avakar/shupito/shupito23/front_design.pdf

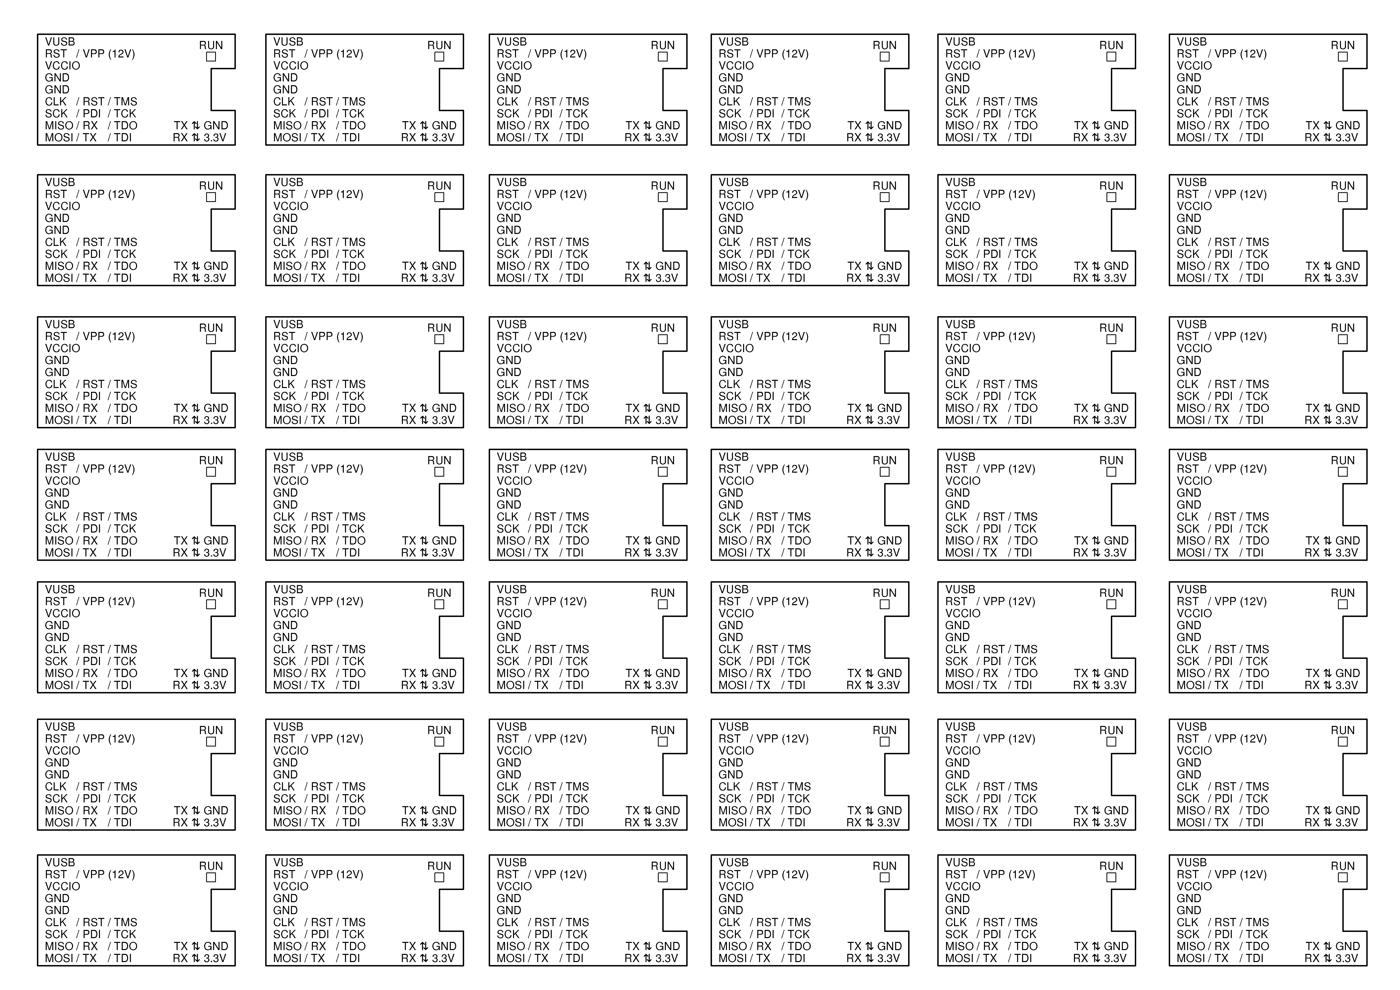
[picture p1: page 1]
