avakar/shupito/shupito23/shupito.brd

## EAGLE design shupito23/shupito.brd (2013-03-26)

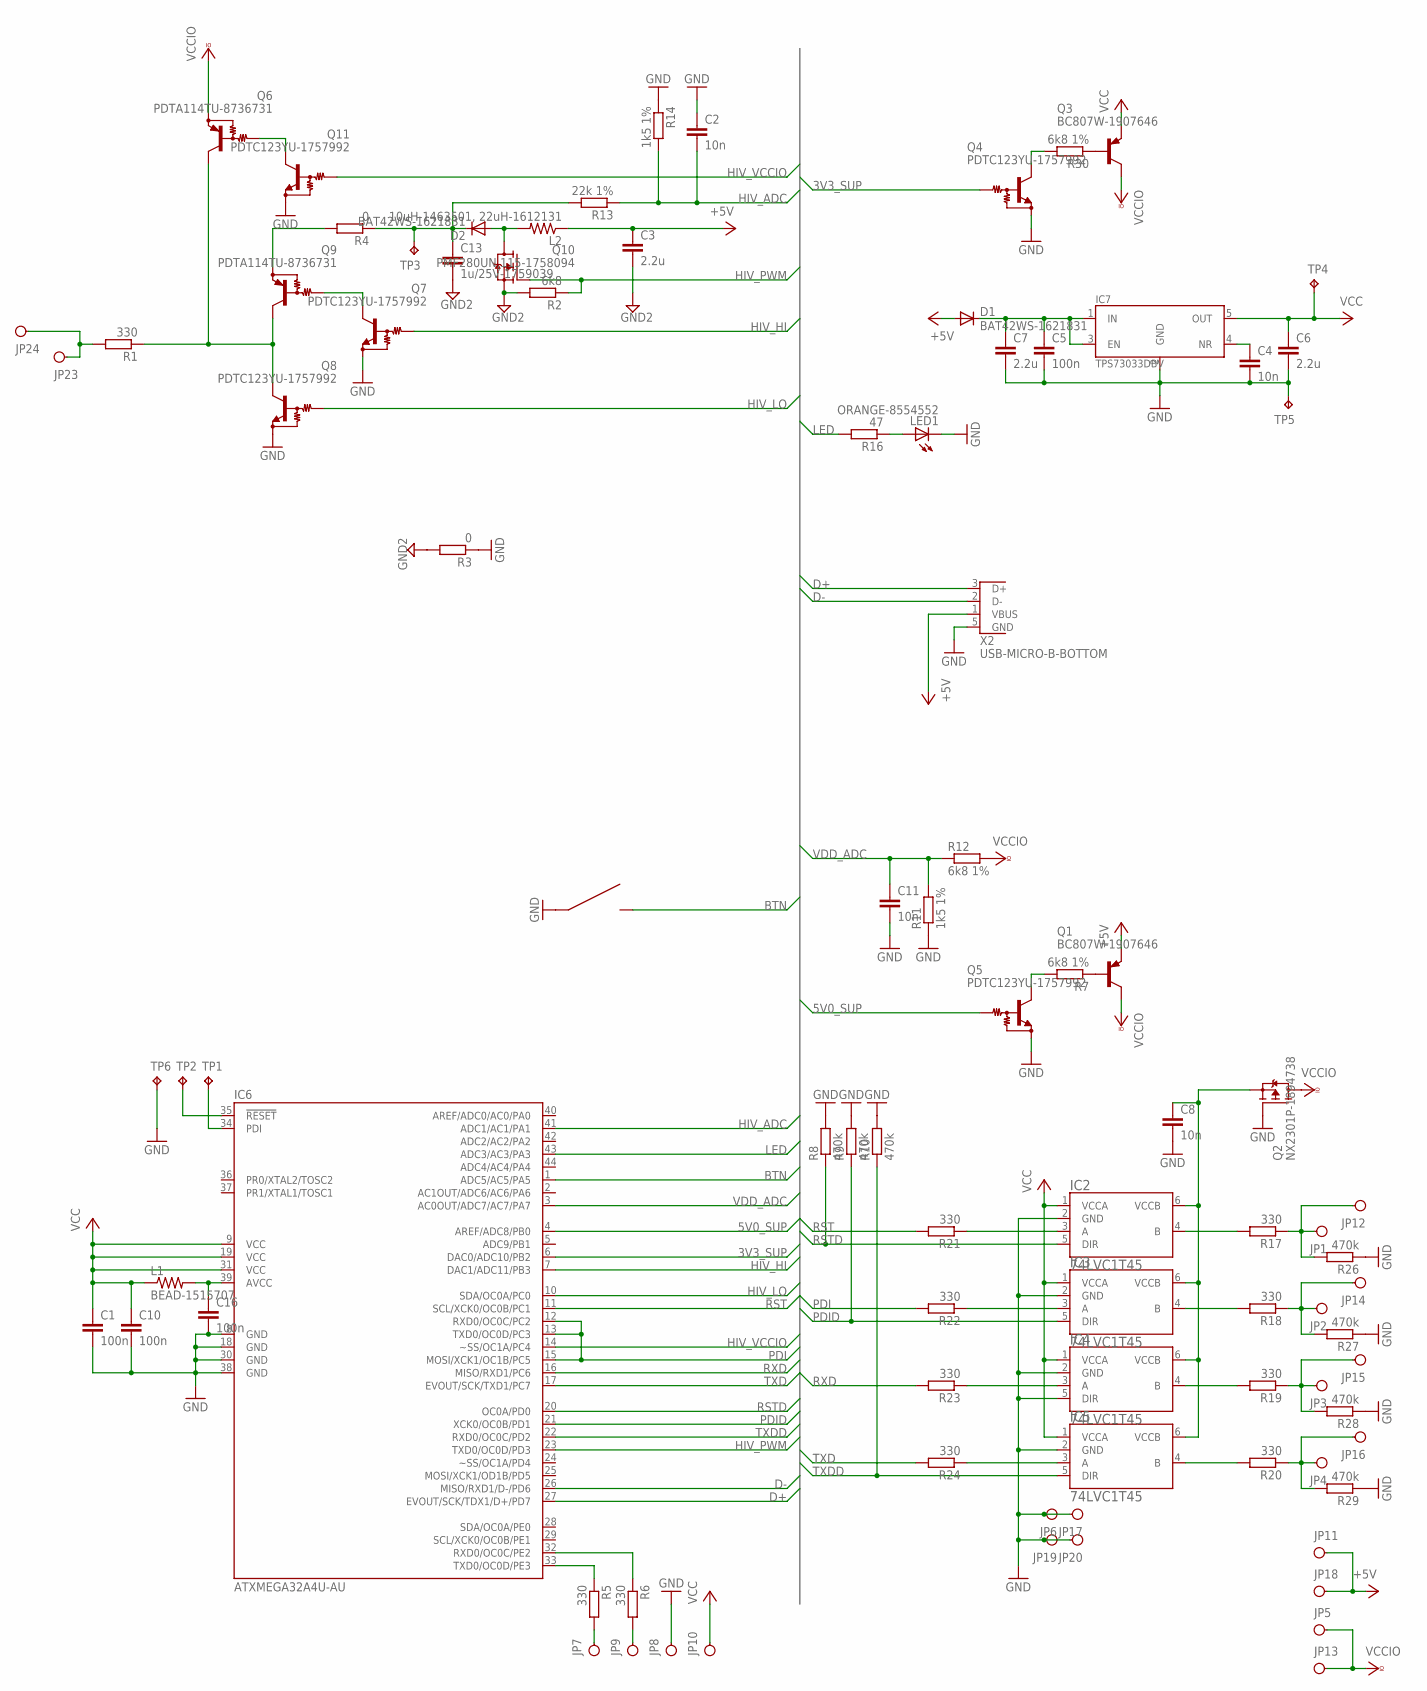
[picture p2: schematic shupito.sch]

Parts:
C1, C5, C10, C16: 100n; C0603K
C2, C4, C8, C11: 10n; C0603K
C3, C6, C7: 2.2u; C0603K
C13: 1u/25V-1759039; C0603K
D1, D2: BAT42WS-1621831; SOD323
IC2, IC3, IC4, IC5: 74LVC1T45; SOT236
IC6: ATXMEGA32A4U-AU; TQFP44
IC7: TPS73033DBV; SOT23-DBV
JP1, JP2, JP3, JP4, JP5, JP6, JP7, JP8, JP9, JP10, JP11, JP12, JP13, JP14, JP15, JP16, JP17, JP18, JP19, JP20, JP23, JP24: PINH1X01SMD
L1: BEAD-1515707; R0603
L2: 10uH-1463501, 22uH-1612131; R0805
LED1: ORANGE-8554552; CHIPLED_0603
Q1, Q3: BC807W-1907646; SOT323-BEC
Q2: NX2301P-1894738; SOT23
Q4, Q5, Q7, Q8, Q11: PDTC123YU-1757992; SOT323
Q6, Q9: PDTA114TU-8736731; SOT323
Q10: PMF280UN,115-1758094; SOT323
R1, R5, R6, R17, R18, R19, R20, R21, R22, R23, R24: 330; R0603
R2: 6k8; R0603
R3, R4: 0; R1206
R7, R12, R30: 6k8 1%; R0603
R8, R9, R10, R26, R27, R28, R29: 470k; R0603
R11, R14: 1k5 1%; R0603
R13: 22k 1%; R0603
R16: 47; R0603
S1: KSS241G; KSS-G
TP1, TP2, TP3, TP4, TP5, TP6: TPTP15SQ; TP15SQ
X2: USB-MICRO-B-BOTTOM; USB-MICRO-B-BOTTOM-MOLEX

Connections:
3V3_SUP: IC6.6 (DAC0/ADC10/PB2), Q4.1 (B)
5V0_SUP: IC6.4 (AREF/ADC8/PB0), Q5.1 (B)
+5V: C3.1, D1.A, JP11.1, JP18.1, L2.1, Q1.2 (E), X2.1 (VBUS)
BTN: IC6.1 (ADC5/AC5/PA5), S1.2
D+: IC6.27 (EVOUT/SCK/TDX1/D+/PD7), X2.3 (D+)
D-: IC6.26 (MISO/RXD1/D-/PD6), X2.2 (D-)
GND: C1.2, C2.1, C4.2, C5.2, C6.2, C7.2, C8.2, C10.2, C11.2, C16.2, IC2.2 (GND), IC3.2 (GND), IC4.2 (GND), IC4.5 (DIR), IC5.2 (GND), IC6.8 (GND), IC6.18 (GND), IC6.30 (GND), IC6.38 (GND), IC7.2 (GND), JP6.1, JP8.1, JP17.1, JP19.1, JP20.1, LED1.C, Q2.1 (G), Q4.2 (E), Q5.2 (E), Q7.2 (E), Q8.2 (E), Q11.2 (E), R3.1, R8.2, R9.2, R10.2, R11.1, R14.1, R26.1, R27.1, R28.1, R29.1, S1.1, TP5.TP, TP6.TP, X2.5 (GND)
GND2: C3.2, C13.2, Q10.2 (S), R2.2, R3.2
HIV_ADC: C2.2, IC6.41 (ADC1/AC1/PA1), R13.1, R14.2
HIV_HI: IC6.7 (DAC1/ADC11/PB3), Q7.1 (B)
HIV_LO: IC6.10 (SDA/OC0A/PC0), Q8.1 (B)
HIV_PWM: IC6.23 (TXD0/OC0D/PD3), Q10.1 (G), R2.1
HIV_VCCIO: IC6.14 (~SS/OC1A/PC4), Q11.1 (B)
LED: IC6.43 (ADC3/AC3/PA3), R16.2
unnamed: IC6.33 (TXD0/OC0D/PE3), R5.1
unnamed: IC6.35 (!RESET), TP2.TP
unnamed: IC6.34 (PDI), TP1.TP
unnamed: D2.A, L2.2, Q10.3 (D)
unnamed: IC2.4 (B), R17.2
unnamed: C16.1, IC6.39 (AVCC), L1.2
unnamed: JP2.1, JP14.1, R18.1, R27.2
unnamed: JP23.1, JP24.1, R1.2
unnamed: IC3.4 (B), R18.2
unnamed: Q6.1 (B), Q11.3 (C)
unnamed: Q9.2 (E), R4.2
unnamed: IC6.32 (RXD0/OC0C/PE2), R6.1
unnamed: C5.1, C7.1, D1.C, IC7.1 (IN), IC7.3 (EN)
unnamed: JP7.1, R5.2
unnamed: LED1.A, R16.1
unnamed: Q7.3 (C), Q9.1 (B)
unnamed: C4.1, IC7.4 (NR)
unnamed: JP9.1, R6.2
unnamed: Q1.1 (B), R7.1
unnamed: C13.1, D2.C, R4.1, R13.2, TP3.TP
unnamed: Q5.3 (C), R7.2
unnamed: IC4.4 (B), R19.2
unnamed: Q4.3 (C), R30.2
unnamed: IC5.4 (B), R20.2
unnamed: Q3.1 (B), R30.1
unnamed: C8.1, IC2.6 (VCCB), IC3.6 (VCCB), IC4.6 (VCCB), IC5.6 (VCCB), Q2.2 (S)
unnamed: IC2.3 (A), R21.1
unnamed: IC3.3 (A), R22.1
unnamed: IC4.3 (A), R23.1
unnamed: IC5.3 (A), R24.1
unnamed: JP1.1, JP12.1, R17.1, R26.2
unnamed: JP3.1, JP15.1, R19.1, R28.2
unnamed: JP4.1, JP16.1, R20.1, R29.2
unnamed: Q6.3 (C), Q8.3 (C), Q9.3 (C), R1.1
PDI: IC6.12 (RXD0/OC0C/PC2), IC6.13 (TXD0/OC0D/PC3), IC6.15 (MOSI/XCK1/OC1B/PC5), R22.2
PDID: IC3.5 (DIR), IC6.21 (XCK0/OC0B/PD1), R9.1
RST: IC6.11 (SCL/XCK0/OC0B/PC1), R21.2
RSTD: IC2.5 (DIR), IC6.20 (OC0A/PD0), R8.1
RXD: IC6.16 (MISO/RXD1/PC6), R23.2
TXD: IC6.17 (EVOUT/SCK/TXD1/PC7), R24.2
TXDD: IC5.5 (DIR), IC6.22 (RXD0/OC0C/PD2), R10.1
VCC: C1.1, C6.1, C10.1, IC2.1 (VCCA), IC3.1 (VCCA), IC4.1 (VCCA), IC5.1 (VCCA), IC6.9 (VCC), IC6.19 (VCC), IC6.31 (VCC), IC7.5 (OUT), JP10.1, L1.1, Q3.2 (E), TP4.TP
VCCIO: JP5.1, JP13.1, Q1.3 (C), Q2.3 (D), Q3.3 (C), Q6.2 (E), R12.2
VDD_ADC: C11.1, IC6.3 (AC0OUT/ADC7/AC7/PA7), R11.2, R12.1

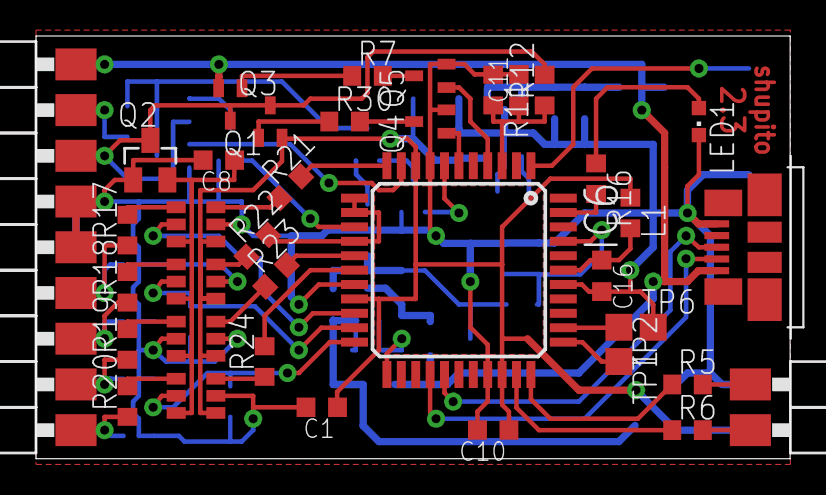
[picture p3: board shupito.brd from above]

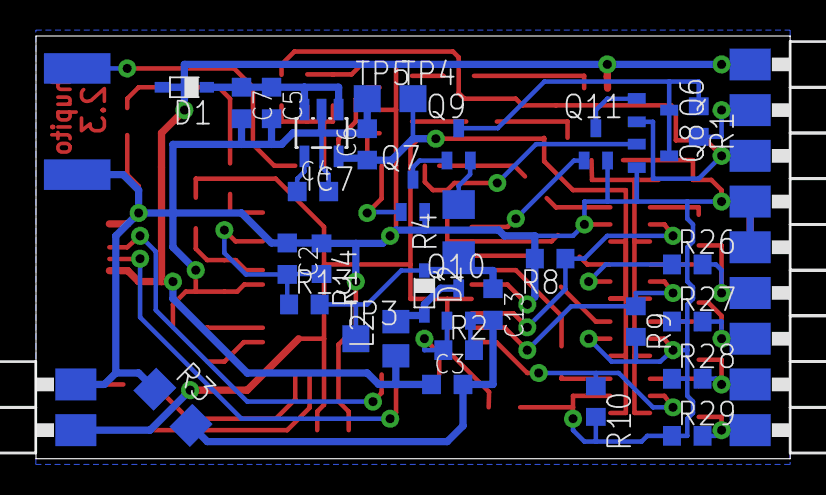
[picture p4: board shupito.brd from below]

Board: 2 copper layers, 41.9 x 23.5 mm, 92 parts (45 on the bottom side), 58 nets.
