avakar/shupito/shupito23/fw_main_xmega/command_handler.cpp

#include "app.hpp"
#include "utils.hpp"
#include "settings.hpp"
#include "../../fw_common/avrlib/serialize.hpp"
#include <string.h>

bool app::handle_packet(uint8_t cmd, uint8_t const * cp, uint8_t size, yb_writer & w)
{
	switch (cmd)
	{
	case 0x0:
		if (size && cp[0] == 1)
		{
			uint8_t * wbuf = w.alloc(0, 1);
			if (!wbuf)
				return false;

			uint8_t err = 1;
			if (size == 3 && cp[1] == 0)
			{
				switch (cp[2])
				{
				case 0:
					err = this->select_handler(&m_handler_avricsp);
					break;
				case 1:
					err = this->select_handler(&m_handler_pdi);
					break;
				case 2:
					err = this->select_handler(&m_handler_spi);
					break;
				case 3:
					err = this->select_handler(&m_handler_jtag);
					break;
				case 4:
					err = this->select_handler(&m_handler_uart);
					break;
				}
			}

			*wbuf = err;
			w.commit();
		}
		else if (size && cp[0] == 2)
		{
			uint8_t * wbuf = w.alloc(0, 1);
			if (!wbuf)
				return false;

			if (size == 3 && cp[1] == 0)
				this->select_handler(0);

			*wbuf++ = 0;
			w.commit();
		}

		break;
	case 0xa:
		if (size == 2 && cp[0] == 0 && cp[1] == 0)
		{
			static uint8_t const vccio_list[] = {
				0, 0,
				0, // flags
				5, 'V', 'C', 'C', 'I', 'O'
			};

			if (!w.send(0xa, vccio_list, sizeof vccio_list))
				return false;

			m_send_vcc_driver_list_scheduled = true;
			m_send_vccio_state_scheduled = true;
		}
		else if (size == 3 && cp[0] == 1 && cp[1] == 2)
		{
			this->set_vccio_drive(cp[2]);
		}

		break;

	case 0xb: // fw update
		if (size == 1 && cp[0] == 0)
			initiate_software_reset();
		break;

	case 0xd: // led
		if (size == 1)
		{
			switch (cp[0])
			{
			case 1:
				led_blink_short();
				break;
			case 2:
				led_blink_long();
				break;
			}
		}
		break;

	case 0x0e: // rename
		if (size > 1 && cp[0] == 0 && (size % 2) == 1 && size <= 61)
		{
			g_namedesc[0] = size + 1;
			g_namedesc[1] = 3;
			memcpy(g_namedesc + 2, cp + 1, size - 1);
			update_settings();
		}
		break;

	case 0x10: // set pwm: 8'kind [32'period 32'duty_cycle]
		{
			uint8_t err = 1;
			if (m_handler != 0 && m_handler != &m_handler_avricsp)
			{
				err = 2;
				m_send_pwm_scheduled = true;
			}
			else if (size >= 1)
			{
				uint8_t kind = cp[0];
				if (kind != 1)
				{
					this->disable_pwm();
					if (kind == 0)
						err = 0;
				}
				else if (size == 9)
				{
					uint32_t period = avrlib::deserialize<uint32_t>(cp + 1);
					uint32_t duty_cycle = avrlib::deserialize<uint32_t>(cp + 5);

					static uint8_t const shifts[] = { 1, 1, 1, 3, 2, 2, 0 };
					uint8_t const * shift_ptr = shifts;
					while (period > 0xffff && *shift_ptr != 0)
					{
						duty_cycle >>= *shift_ptr;
						period >>= *shift_ptr++;
					}

					if (period <= 0xffff)
					{
						uint8_t presc = (shift_ptr - shifts) + 1;

						m_pwm_kind = 1;
						m_pwm_period = period;
						m_pwm_duty_cycle = duty_cycle;
						while (shift_ptr != shifts)
						{
							--shift_ptr;
							m_pwm_period <<= *shift_ptr;
							m_pwm_duty_cycle <<= *shift_ptr;
						}

						pin_aux_rst::make_input();
						TCC0_CTRLA = 0;
						TCC0_PER = period;
						TCC0_CCB = duty_cycle;
						TCC0_CTRLB = TC0_CCBEN_bm | TC_WGMODE_SINGLESLOPE_gc;
						TCC0_CTRLA = presc;
						pin_aux_rst::make_low();
						m_send_pwm_scheduled = true;
						err = 0;
					}
				}
			}

			w.send_sync(0x10, &err, 1);
		}
		break;

	case 0x11: // get pwm
		m_send_pwm_scheduled = true;
		break;

	default:
		if (m_handler)
			return m_handler->handle_command(cmd, cp, size, w);
	}

	return true;
}
