avakar/shupito/shupito1/firmware/desc.h

0x01, 0x4b, 0xd5, 0x4f, 0x48, 0xf4, 0x13, 0x41, 0x0a, 0x91, 0xb3, 0x34, 0x29, 0x1e, 0x03, 0xbd,
0xb1, 0x82, 0x00, 0x00, 0x46, 0xdb, 0xc8, 0x65, 0xb4, 0xd0, 0x46, 0x6b, 0x9b, 0x70, 0x2f, 0x3f,
0x5b, 0x26, 0x4e, 0x65, 0x01, 0x08, 0x00, 0x00, 0x00, 0x71, 0xef, 0xb9, 0x03, 0x30, 0x30, 0x4f,
0xd3, 0x88, 0x96, 0x19, 0x46, 0xab, 0xa3, 0x7e, 0xfc, 0x01, 0x08, 0x00, 0x50, 0x08,
