avakar/shupito/(commit log)

2011-03-02 initial import
    [shupito.brd, shupito.sch]
2011-03-05 Finished routing. Ready for etching.
    [shupito.brd, shupito.sch]
2011-03-12 Added the firmware project with a sketch of the PDI interface driver.
2011-04-10 A few fixes; the transmission of NVM key is now implemented.
    [main.cc]
2011-04-15 Directory reorganization.
    [shupito.brd, shupito.sch]
2011-04-17 Reading, erasing and programming fuses now works for pdi. icsp is broken.
    [chipdefs.cpp, chipdefs.hpp, main.cc, pdi.hpp]
2011-04-17 Fixed device descriptions for atxmegaa4 devices.
    [chipdefs.cpp]
2011-04-25 Factored the PDI-related functionality and command handling out of the main file.
    The main loop now merely dispatches commands (other than command 0) to a handler.
    There is currently only one handler, but more can be added (this is a preparation
    for the readdition of the classical SPI programmer). It will later be possible to
    switch between handlers dynamically through command 0.
2011-04-25 Added the 'fuses' memory definition to the chipdefs of all 'avr' chips.
    The memory section is added automatically if it is missing from the definition
    string. The memory section is always four bytes long. For now, all xmega chips
    (which have different size of the fuse memory) have the section defined
    explicitely.
    [chipdefs.cpp]
2011-04-25 Added support for the classic AVR SPI programming.
    The SPI programmer is currently selected as the default
    and cannot be changed. The PDI programming capability
    is therefore temporarily disabled.
    The bootseq check is now performed outside the command parsing.
    Otherwise, attempts to flash a program containing the bootload sequence
    would reset the programmer.
    [handler_avricsp.hpp, handler_base.hpp, handler_xmega.hpp, main.cc, spi.hpp]
2011-04-25 Added the ability to switch between spi and pdi programming mode.
    The signatures of xmega devices now reside in 'avrx' namespace.
    The mode selection is persistent until the programmer is reset.
    [chipdefs.cpp, handler_avricsp.hpp, handler_base.hpp, handler_xmega.hpp, main.cc]
2011-07-03 Started v2.0 rework -- xmega and level translators.
    [shupito.brd, shupito.sch]
2011-07-04 usb chip, reg, ext_sup
    [shupito.brd, shupito.sch]
2011-07-04 started routing
    [shupito.brd]
2011-07-05 routing, phase 1
    [shupito.brd, shupito.sch]
2011-07-06 some more routing
    [shupito.brd, shupito.sch]
2011-07-06 some more routing, added support for pinhead receptacle for bth instead of pinheads
    [shupito.brd, shupito.sch]
2011-07-06 Added voltage measurement, removed a few capacitors.
    [shupito.brd, shupito.sch]
2011-07-06 added diode, 0402->0603
    [shupito.brd, shupito.sch]
2011-07-06 4.7u A->1206
    [shupito.brd, shupito.sch]
2011-07-12 Fuses can now be programmed via SPI ICSP programming.
2011-07-23 Fixed the pagesize of atmega8u2 in the client.
    [chipdefs.cpp]
2011-07-24 USB<->UART translation now basically works.
2011-07-24 Added the libusb0-based driver.
2011-07-26 Added support for GET_STATUS request, some stalling on errors.
2011-07-31 Fixed shupito v1 (m162) firmware so that the slave xmega chip can be stopped and started repeatedly.
    [handler_xmega.hpp, pdi.hpp]
2011-08-07 Fixed the output stage (DIR is powered by VCCA), rerouted.
    [shupito.brd, shupito.sch]
2011-08-11 The USB chip now has an 8MHz (the chip shouldn't run at 16MHz at 3.3V).
    [shupito.brd, shupito.sch]
2011-08-11 The USB chip's oscillator now drives xmega's clock input.
    [shupito.brd, shupito.sch]
2011-08-11 Connected XCK between the chips (allowing synchronous USART for faster communication).
    [shupito.brd, shupito.sch]
2011-08-11 Added components for a switched supply. Needs placement and routing.
    [shupito.brd, shupito.sch]
2011-08-12 Switched supply placement and routing.
    [shupito.brd, shupito.sch]
2011-08-14 Finished power supply design, replaced 5VOUT transistor with a bipolar one.
    [shupito.brd, shupito.sch]
2011-08-14 Added a transistor to guard against reverse polarity on VCCIO.
    [shupito.brd, shupito.sch]
2011-08-14 Repositioned the switched and LDO supplies. Added LED.
    [shupito.brd, shupito.sch]
2011-08-14 Increased the width of power lines.
    [shupito.brd, shupito.sch]
2011-08-14 Slight rearrangement.
    [shupito.brd, shupito.sch]
2011-08-14 Fixed up values of some parts.
    [shupito.brd, shupito.sch]
2011-08-16 Added a diode to VDD.
    [shupito.brd, shupito.sch]
2011-08-16 Fixed values of adc resistor dividers.
    [shupito.brd, shupito.sch]
2011-08-16 Added protective resistors; final touches.
    [shupito.brd, shupito.sch]
2011-08-16 Some more DRC settings.
    [shupito.brd]
2011-09-11 Fixed bootrst fuse settings for atxmega a4 devices.
    [chipdefs.cpp]
2011-09-12 Added a pullup for CE on the DCDC converter; changed DCDC output cap to a tantalum. A bunch of moved lines.
    [shupito.brd, shupito.sch]
2011-09-20 New yb descriptor protocol, spi/pdi handlers, sketch of VDD measurement.
2011-09-22 Added VDD measurement and control, fixed the device desc,.
    [create_descriptor.py, desc.h, main.cc]
2011-09-22 vdd_drive is now ordered <hiz>, 5V.
2011-09-25 Added a test pad for emergency bootloader activation for the USB chip.
    [shupito.brd, shupito.sch]
2011-09-25 Removed debug print statements from USB chip output.
2011-09-26 Fixed pin assignments and polarity. app pipe now works correctly.
    [main.cc]
2011-10-05 SPI programming now works. ADC slowed down to allow the SH cap to charge.
2011-10-08 app pipe now gets automatically disabled when spi is enabled.
2011-10-08 Voltage measurement descriptors and status.
2011-10-08 PDI is now correctly cleared when an error occurs.
    [handler_xmega.hpp]
2011-10-09 Modified interrupt priorities slightly.
2011-10-15 board: hw flow control, prep for 3v3 ext sup, output pull-downs.
    [shupito.brd, shupito.sch]
2011-10-15 Prepared for flow-controlled inner comm.
2011-10-16 3v3 ext sup, adc filter
    [shupito.brd, shupito.sch]
2011-10-29 Consolidated parts, created partlist.
    [shupito.brd, shupito.sch]
2011-10-29 A few final touches.
    [shupito.brd, shupito.sch]
2011-11-17 Final revision.
    [shupito.brd, shupito.sch]
2011-11-20 Fixed read memory in SPI mode.
    [handler_avricsp.hpp]
2011-11-26 Fixed read memory command for xmega.
    [handler_xmega.hpp]
2011-11-26 Added eeprom read/write for spi.
2011-11-29 Fixed the delay between reset and prog enable sequence in spi.
    [handler_avricsp.hpp]
2011-12-03 Decreased the VCCIO emergency shutdown voltage to 4.4V.
2011-12-03 Fixed a few PDI time constants.
    [main.cc]
2011-12-03 Added a 100us wait when switching from RX to TX (PDI requires at least one idle bit).
2011-12-04 Final touches for 2.2.
    [shupito.brd, shupito.sch]
2011-12-10 Fixed handling of chips larger than 0x8000.
    [handler_xmega.hpp]
2011-12-11 3.3V output support, reverted USB chip to 8MHz (can't run at 16MHz at this voltage).
    [create_descriptor.py, desc.h, main.cc]
2011-12-16 Added VUSB measurement, switched reg control.
2011-12-29 Fixed the USB driver.
2012-03-03 Shupito 2.3, hiv instead of boost reg.
    [shupito.brd, shupito.sch]
2012-03-24 Some more routing.
    [shupito.brd, shupito.sch]
2012-03-24 Added a button, placement and routing.
    [shupito.brd, shupito.sch]
2012-03-26 Added a protection diode for the 3.3v ldo.
    [shupito.brd, shupito.sch]
2012-03-30 Added generic SPI communication.
2012-04-01 Added hardware flow control to shupito 2.2
2012-04-04 Fixed internal flow control.
    [main.cc]
2012-04-06 Fixed the "USB device can perform faster" popup.
2012-04-06 Fixed flow control (hw can't be used on 8u2 due to the lack of hw control on the xmega side).
2012-04-07 Upgraded to AVR Studio 5, added version info to the device's yb descriptor.
2012-06-24 Fixed hg revision fetch when color extension is enabled.
    [create_descriptor.py]
2012-06-24 Shupito no longer creates /dev/ttyACM0 devices.
2012-07-29 avricsp now respects fuse read size and offset.
2012-09-18 Added GND and VCC to AUX connector.
    [shupito.brd, shupito.sch]
2012-09-19 Added protective resistors.
    [shupito.brd, shupito.sch]
2012-10-23 Increased drill size to 0.5mm.
    [shupito.brd, shupito.sch]
2012-10-24 Added a CAM job for Gerber/Excellon export.
2012-11-05 Added a part name.
    [shupito.brd, shupito.sch]
2012-11-17 shupito2->shupito23 in preparation of branch merge
    [shupito.brd, shupito.sch]
2012-12-19 shupito23: spi
2012-12-20 A bit of power and noise reduction.
    [app.cpp]
2012-12-20 Basic support for high voltage generation.
2012-12-21 Added driver for shupito23.
2012-12-21 shupito23: Selected better transistors for the rst pin.
    [shupito.brd, shupito.sch]
2012-12-21 shupito23: RST pin now support hiv output.
2012-12-21 shupito23: fixed up yb descriptor.
    [create_descriptor.py]
2012-12-21 shupito23: refactoring, removed some debug prints.
2012-12-21 Added averaging filter for vccio measurements.
2012-12-21 shupito23: fixed SPI communication
    [app.cpp, spi.cpp]
2012-12-22 shupito23: hardware button
2012-12-22 Led will now blink on tunnel connect or on host trigger.
2012-12-22 shupito23: blink on USB reset.
    [usb.cpp]
2013-01-13 shupito23: added another thunner through the bth connector.
2013-01-25 Added front cover layer to shupito23
    [shupito.brd]
2013-01-25 Some more front design.
    [shupito.brd]
2013-01-25 Some more front cover design
    [shupito.brd]
2013-01-27 shupito23: fixed hiv constants.
    [hiv.cpp]
2013-01-27 shupito23: PDI interface fixes, added debug pins.
    [app.cpp, handler_xmega.hpp, pdi.hpp, pdi_instr.hpp, pins.hpp]
2013-01-27 shupito23: updated front design
    [shupito.brd]
2013-01-28 shupito23: tunnel writes now go through DMA
2013-01-31 shupito23: fixed baudrate table.
    [generate_baudctrls.py]
2013-01-31 shupito23: DMA-based tunnel transfers.
2013-02-02 shupito23: fixed settings of tunnel baudrate.
    [app.cpp]
2013-02-28 shupito23: fixed baudrates (bsel == 0 implies bscale == 0)
    [generate_baudctrls.py]
2013-03-09 shupito23: the device name is now stored in eeprom and can be changed
2013-03-11 shupito23: the tunnel no longer interferes with spi
    [tunnel.cpp, usb.cpp]
2013-03-15 shupito23: generic SPI communication support
2013-03-24 shupito23: added a missing assert.
    [handler_base.hpp]
2013-03-24 shupito23: refactoring in preparation for DMA-based JTAG pattern generation
2013-03-24 shupito23: implemented continuous clock, DMA-based JTAG
2013-03-26 shupito23: updated Farnell OC for 2.2uF
    [shupito.brd, shupito.sch]
2013-03-27 shupito23: fixed up DMA channel priorities
    [app.cpp, handler_jtag_fast.cpp, tunnel.cpp]
2013-03-27 shupito23: HIV pin handling for JTAG
2013-03-27 shupito22: fixed old JTAG support
    [handler_jtag.hpp]
2013-06-01 shupito23: jtag no longer drops the last bit of a shift
    [handler_jtag_fast.cpp]
2013-06-16 shupito23: added PWM generator
2013-07-25 SPI handler will now accept mode and bitorder flags.
2014-02-16 shupito23: increased nvm reset timeout to account for 64ms reset hold
    [handler_xmega.hpp]
2014-08-16 shupito23: implemented app tunnel, bitbang in uart mode
